thinking0things/duckbert/cad/out_none_v1.1/Microduck_SG90_headless_v1_1.FCStd

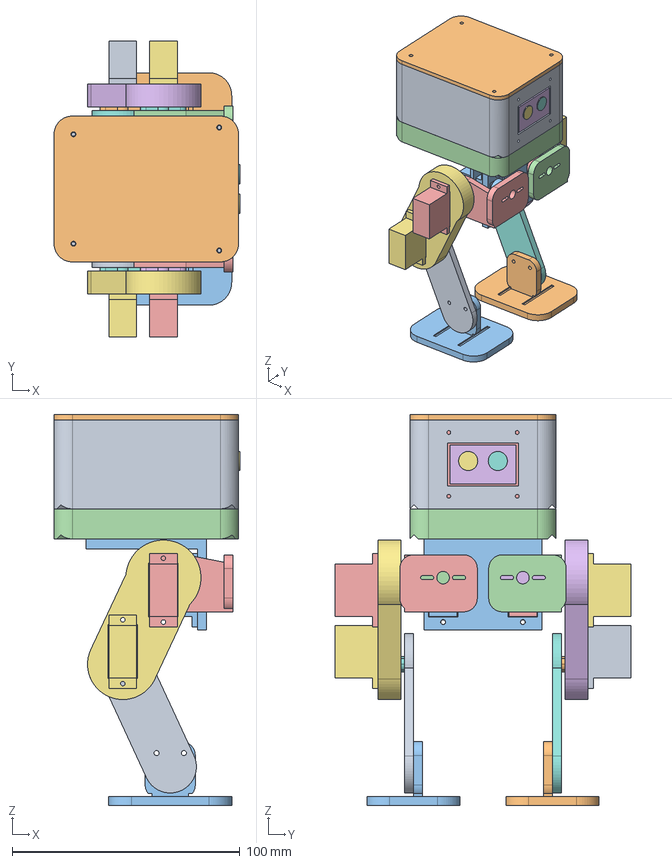
[picture p3: CAD file, 2026-09-23]
cad/out_none_v1.1/Microduck_SG90_headless_v1_1.FCStd
81.6 x 130.0 x 171.6 mm
01 trunk tub
02 trunk lid
03 hip block
04 hip bracket L
04 hip bracket R
05 thigh L
05 thigh R
06 shin L
06 shin R
07 foot L
07 foot R
15 lipo cassette
L_hip_roll
L_hip_roll_stock_horn
L_hip_pitch
L_hip_pitch_stock_horn
L_knee
L_knee_stock_horn
R_hip_roll
R_hip_roll_stock_horn
R_hip_pitch
R_hip_pitch_stock_horn
R_knee
R_knee_stock_horn
ESP32_C3_shield_envelope
regulator_5V_envelope
IMU_GY521_envelope
battery_lipo_envelope
OLED_1in3_envelope
OLED_screen
OLED_eye_R
OLED_eye_L
