thinking0things/duckbert/cad/out_none_v1.1/plates/plate_all_parts.stl

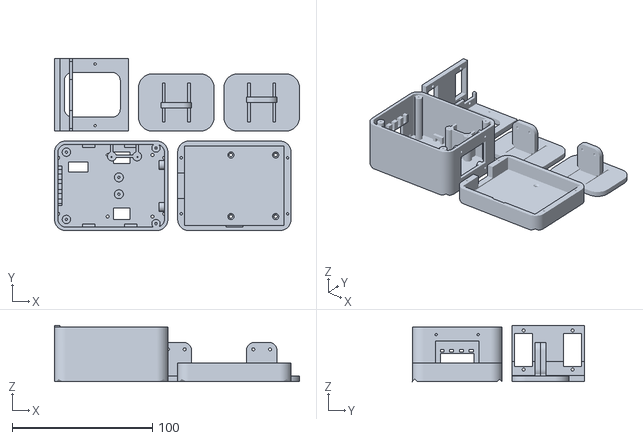
[picture p4: CAD file, 2026-09-23]
cad/out_none_v1.1/plates/plate_all_parts.stl
175.0 x 123.0 x 40.0
