thinking0things/duckbert/cad/out_none_v1.1/stl/07_foot_L.stl

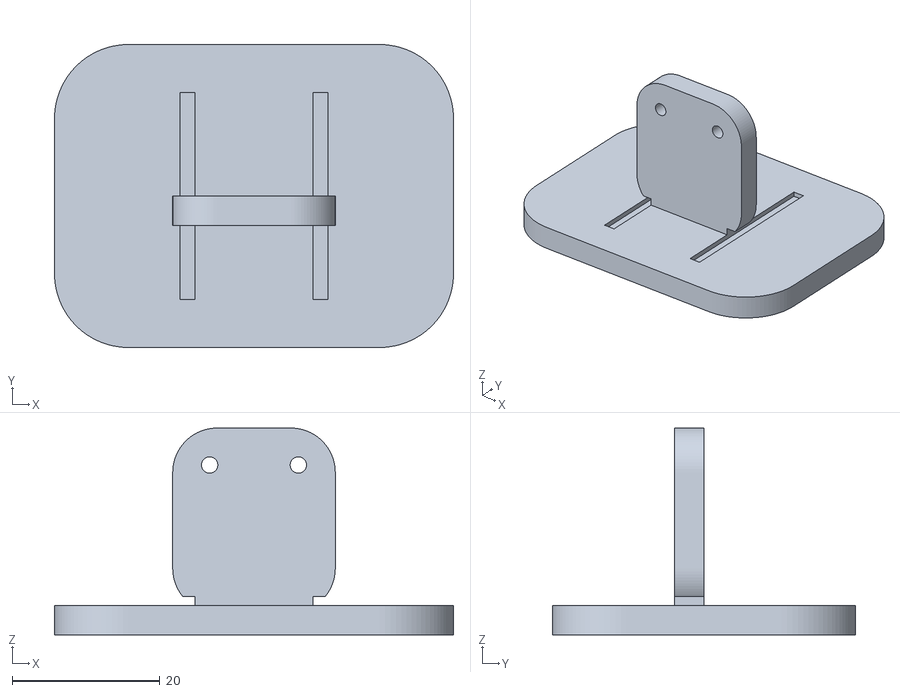
[picture p5: CAD file, 2026-09-23]
cad/out_none_v1.1/stl/07_foot_L.stl
54.0 x 41.0 x 28.0
