thinking0things/duckbert/cad/v1.3/Duckbert_v1_3.FCStd

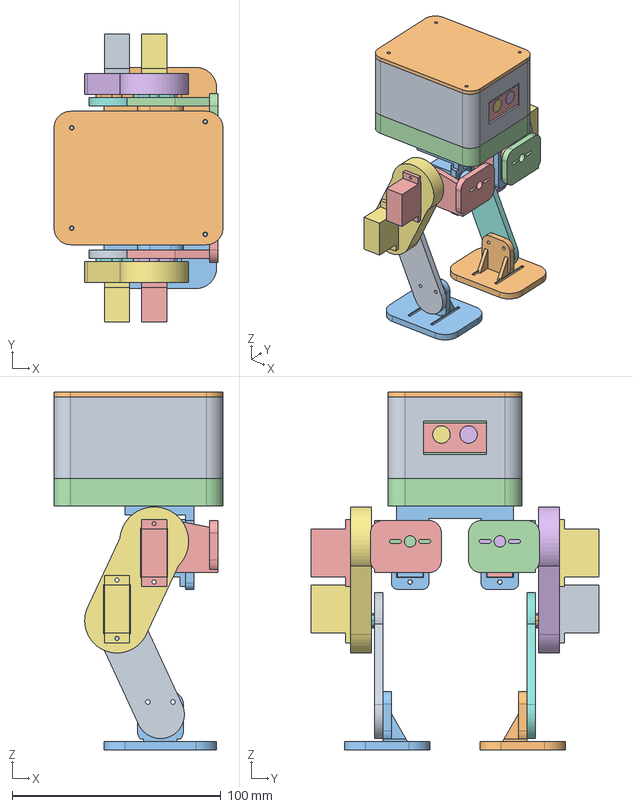
[picture p6: CAD file, 2026-10-14]
cad/v1.3/Duckbert_v1_3.FCStd
81.0 x 138.0 x 171.6 mm
01 trunk tub — r3 leads, USB, gyro 17, shield 10, OLED bosses
02 trunk lid
03 hip block — hip22 r2 supported front bridge
04 hip bracket L
04 hip bracket R
05 thigh L
05 thigh R
06 shin L
06 shin R
07 foot L
07 foot R
15 lipo cassette
L_hip_roll
L_hip_roll_stock_horn
L_hip_pitch
L_hip_pitch_stock_horn
L_knee
L_knee_stock_horn
R_hip_roll
R_hip_roll_stock_horn
R_hip_pitch
R_hip_pitch_stock_horn
R_knee
R_knee_stock_horn
regulator_5V_envelope
IMU_GY521_envelope
battery_lipo_65x55x10
OLED_1in3_envelope
OLED_screen
OLED_eye_L
OLED_eye_R
ESP32-C3 shield — existing 30 x 26 mm envelope
