thinking0things/duckbert/cad/v1.3/hip_block_r2/03_hip_block_hip22_r2.step

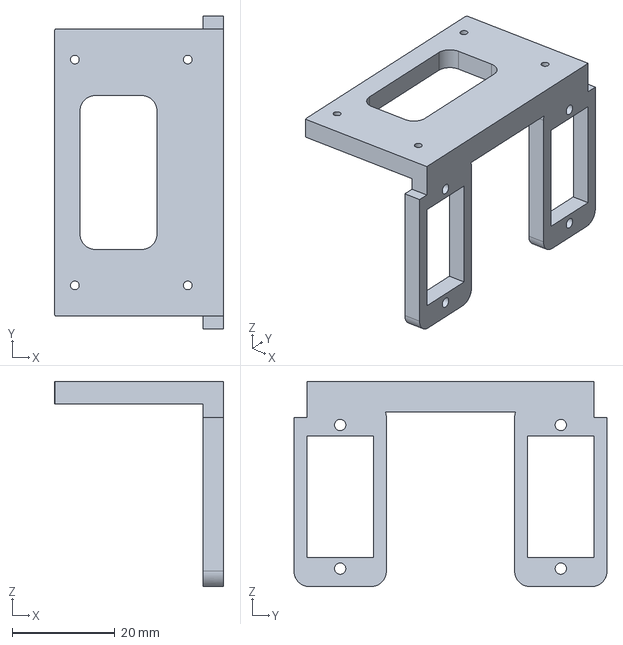
[picture p7: CAD file, 2026-10-14]
cad/v1.3/hip_block_r2/03_hip_block_hip22_r2.step
33.0 x 61.0 x 40.0 mm
