thinking0things/duckbert/cad/v1.3/step/05_thigh_L.step

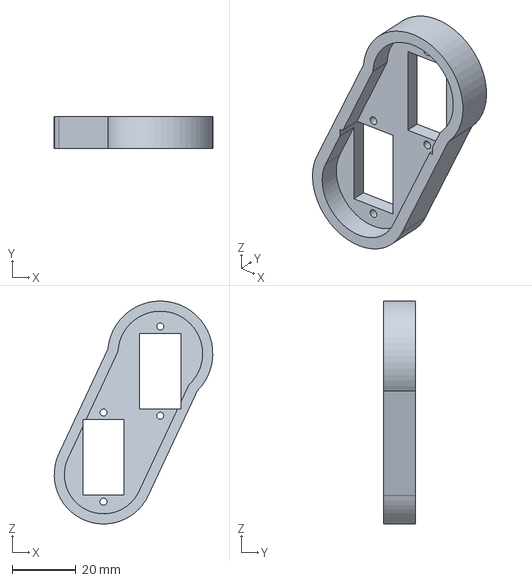
[picture p8: CAD file, 2026-10-14]
cad/v1.3/step/05_thigh_L.step
49.8 x 10.0 x 70.0 mm
