thinking0things/duckbert/cad/v1.3/step/shoes/01_rocker_shoe.step

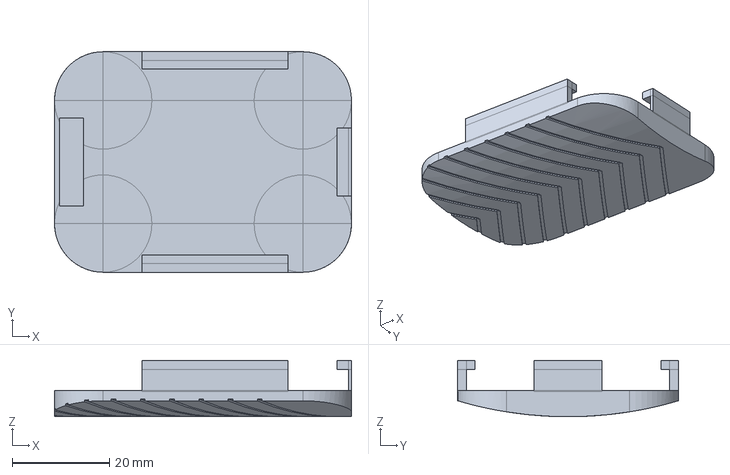
[picture p9: CAD file, 2026-10-14]
cad/v1.3/step/shoes/01_rocker_shoe.step
61.0 x 45.3 x 11.6 mm
