thinking0things/duckbert/dist/assets/meshes/R_hip_roll.stl

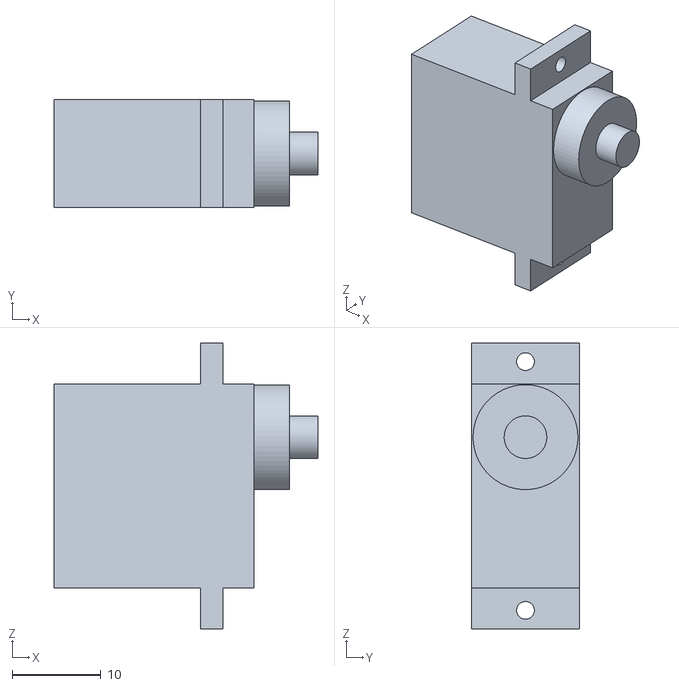
[picture p10: CAD file, 2026-09-24]
dist/assets/meshes/R_hip_roll.stl
29.7 x 12.2 x 32.2
