thinking0things/duckbert/print/00_servo_fit_coupon.stl

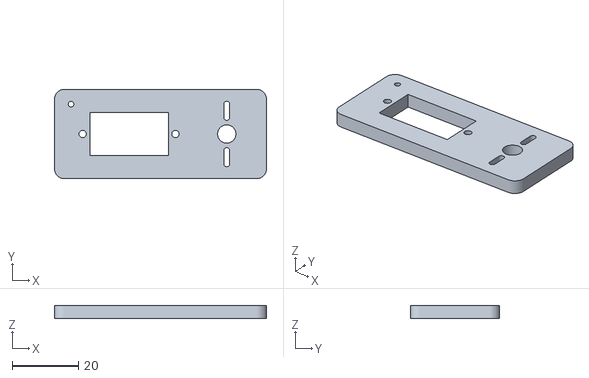
[picture p11: CAD file, 2026-09-23]
print/00_servo_fit_coupon.stl
64.0 x 27.0 x 4.00
