thinking0things/duckbert/print/body/01_trunk_tub.3mf

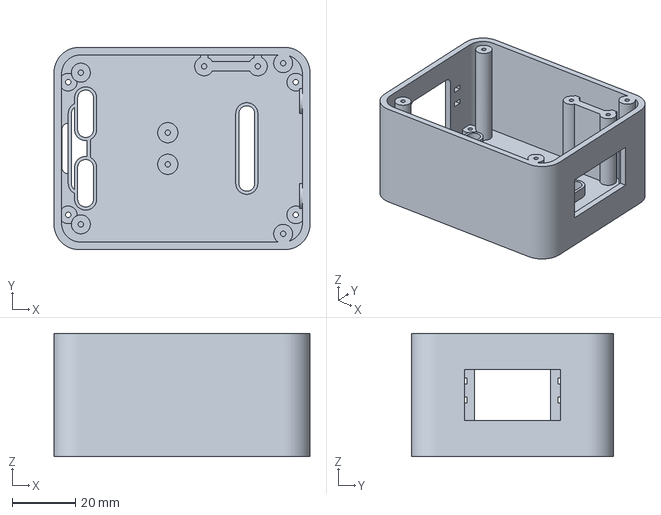
[picture p12: CAD file, 2026-10-14]
print/body/01_trunk_tub.3mf
81.0 x 64.0 x 39.0 mm
