thinking0things/duckbert/print/hips/04_hip_bracket_L.stl

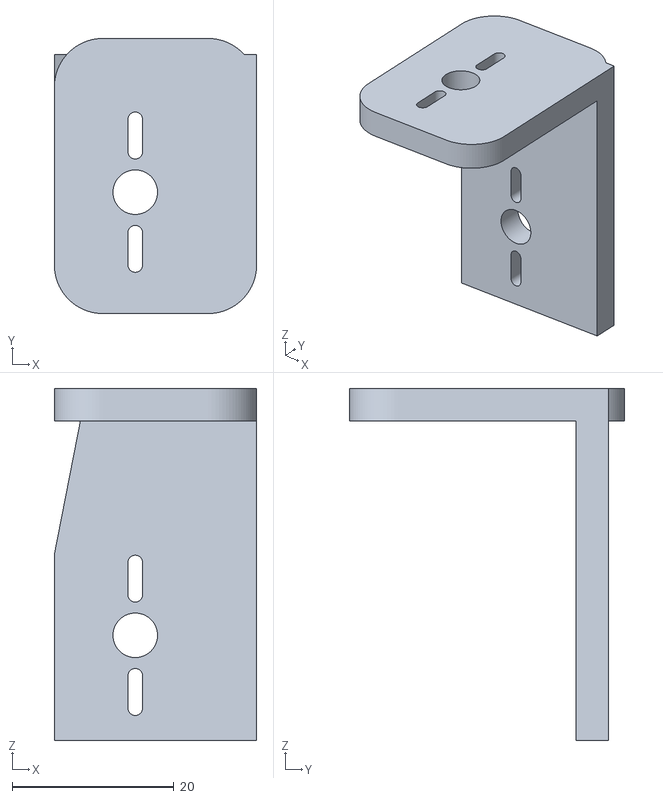
[picture p13: CAD file, 2026-10-14]
print/hips/04_hip_bracket_L.stl
25.0 x 34.0 x 43.5
