thinking0things/duckbert/print/shoes/shoes_plate_x2.3mf

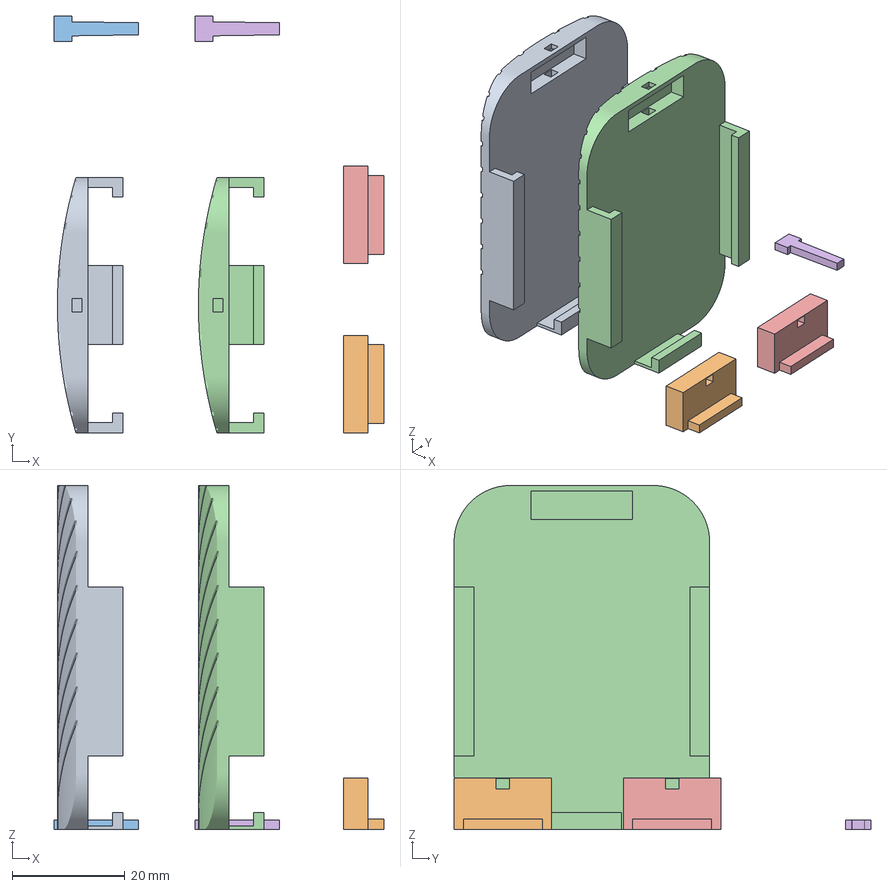
[picture p14: CAD file, 2026-10-14]
print/shoes/shoes_plate_x2.3mf
58.5 x 73.9 x 61.0 mm
01_rocker_shoe
02_rear_gate
03_taper_key
