thinking0things/duckbert/cad/out_none_v1.1/stl/01_trunk_tub.stl

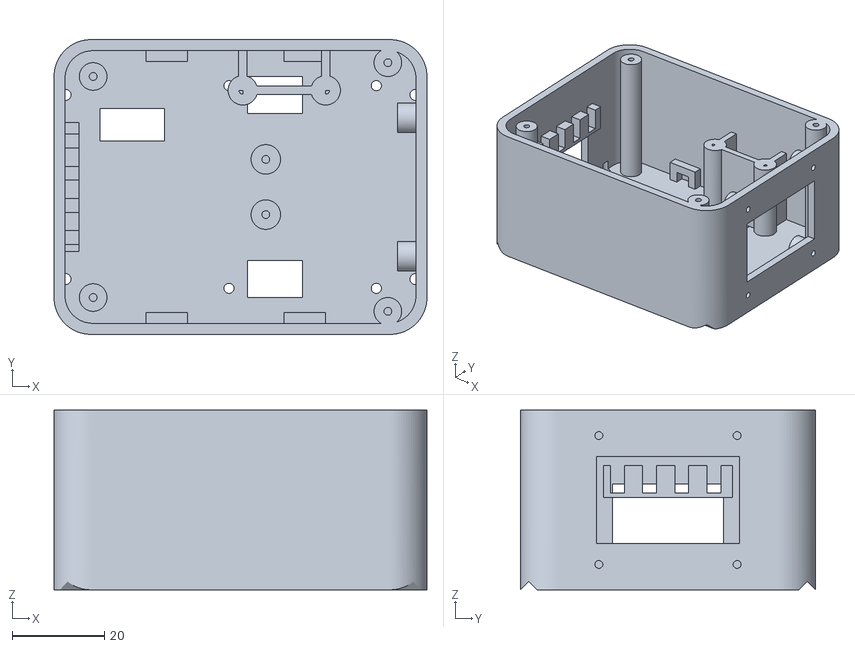
[picture p15: CAD file, 2026-09-23]
cad/out_none_v1.1/stl/01_trunk_tub.stl
81.0 x 64.0 x 39.0
