thinking0things/duckbert/cad/v1.3/step/07_foot_L.step

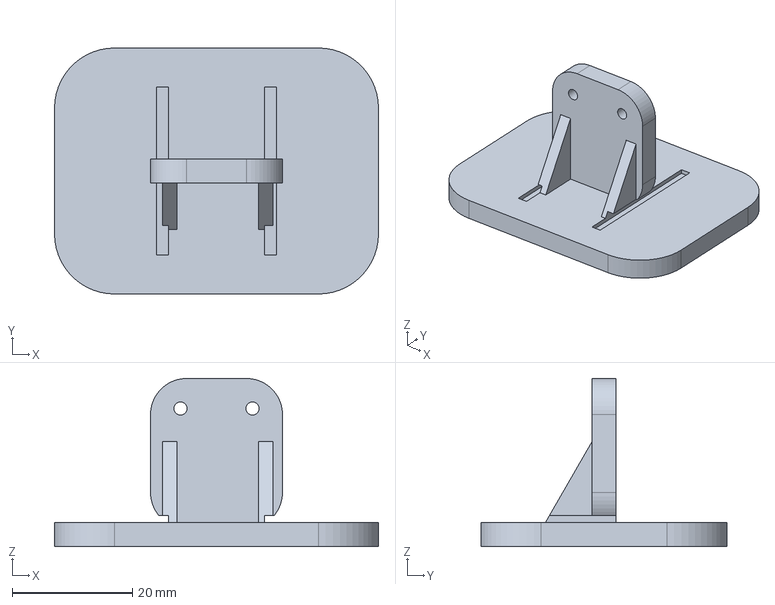
[picture p16: CAD file, 2026-10-14]
cad/v1.3/step/07_foot_L.step
54.0 x 41.0 x 28.0 mm
