thinking0things/duckbert/cad/v1.3/step/shoes/03_taper_key.step

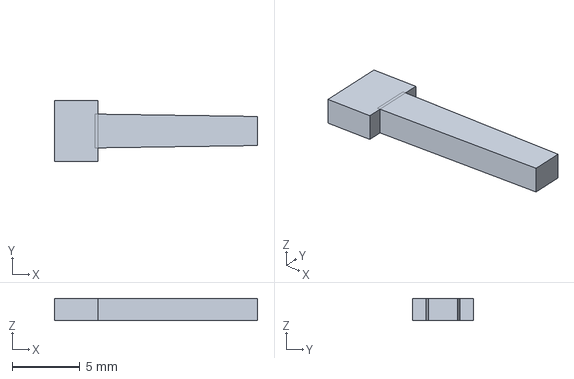
[picture p17: CAD file, 2026-10-14]
cad/v1.3/step/shoes/03_taper_key.step
15.0 x 4.50 x 1.65 mm
