thinking0things/duckbert/dist/assets/meshes/06_shin_L.stl

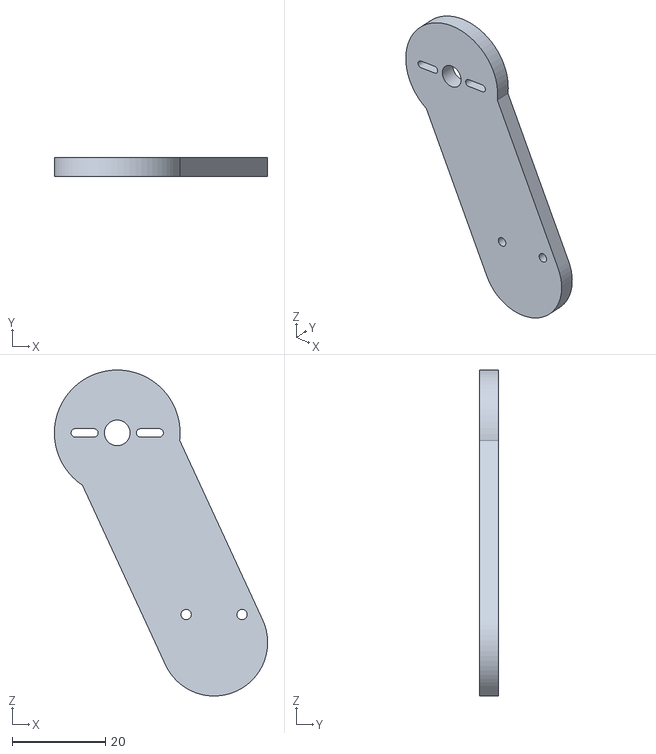
[picture p18: CAD file, 2026-09-24]
dist/assets/meshes/06_shin_L.stl
45.8 x 4.00 x 70.0
