thinking0things/duckbert/print/body/02_trunk_lid.stl

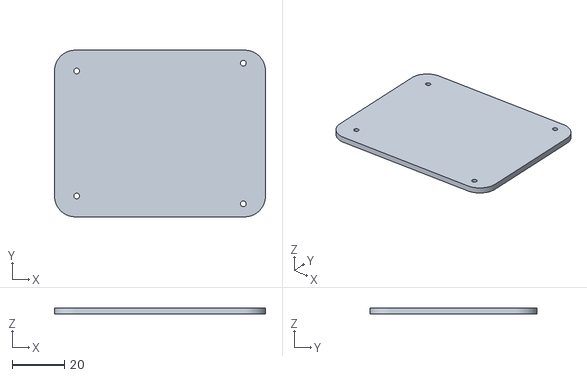
[picture p19: CAD file, 2026-09-23]
print/body/02_trunk_lid.stl
81.0 x 64.0 x 2.40
