thinking0things/duckbert/cad/out_none_v1.1/stl/15_lipo_cassette.stl

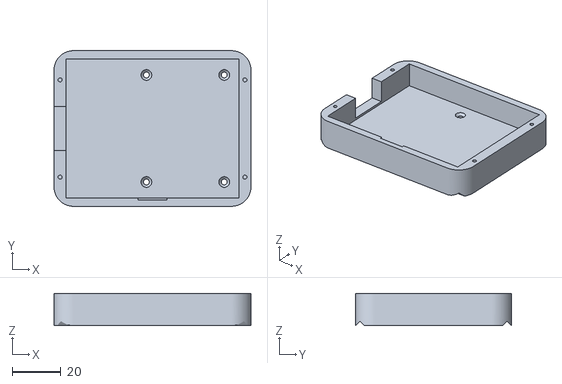
[picture p20: CAD file, 2026-09-23]
cad/out_none_v1.1/stl/15_lipo_cassette.stl
81.0 x 64.0 x 13.2
