thinking0things/duckbert/cad/v1.3/step/shoes/00_fit_coupon.step

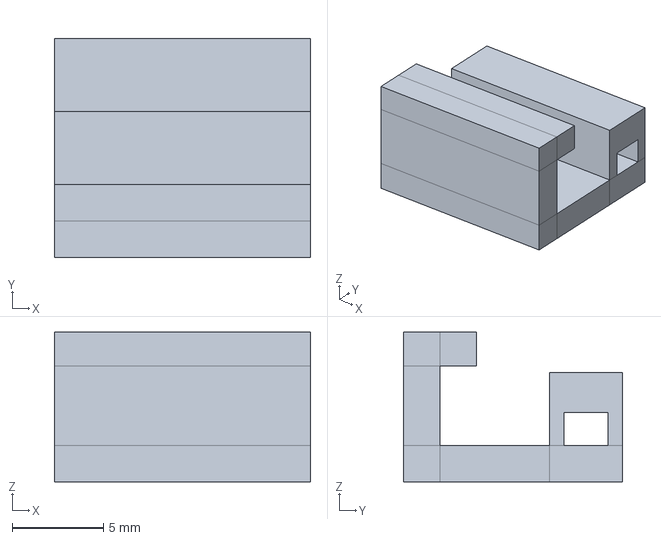
[picture p21: CAD file, 2026-10-14]
cad/v1.3/step/shoes/00_fit_coupon.step
14.0 x 12.0 x 8.20 mm
