thinking0things/duckbert/dist/assets/meshes/L_knee_stock_horn.stl

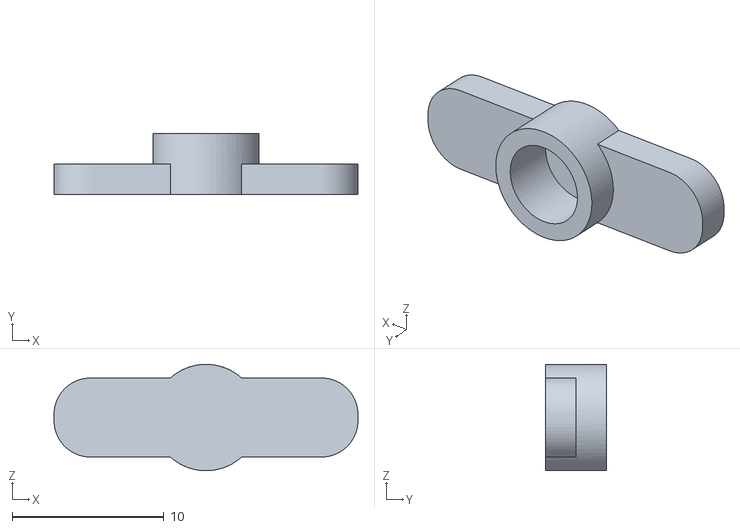
[picture p22: CAD file, 2026-09-24]
dist/assets/meshes/L_knee_stock_horn.stl
20.0 x 4.00 x 7.00
