thinking0things/duckbert/print/hips/03_hip_block.stl

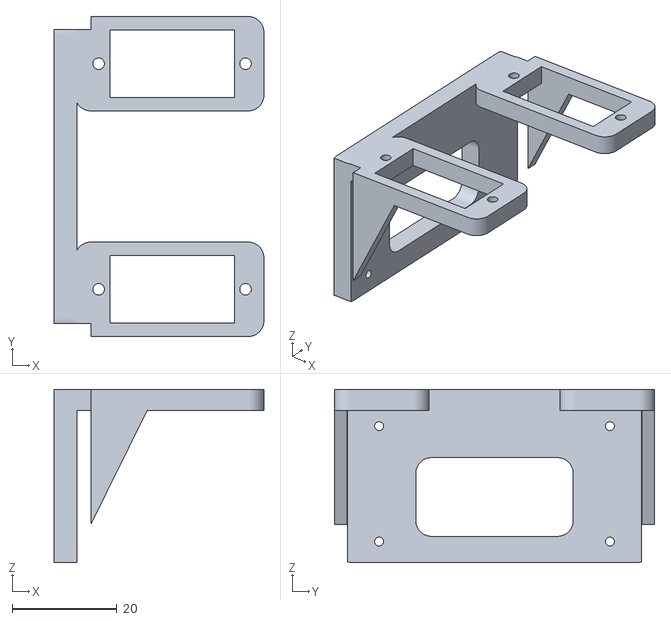
[picture p23: CAD file, 2026-10-14]
print/hips/03_hip_block.stl
40.0 x 61.0 x 33.0
