thinking0things/duckbert/print/shoes/shoe_fit_test.3mf

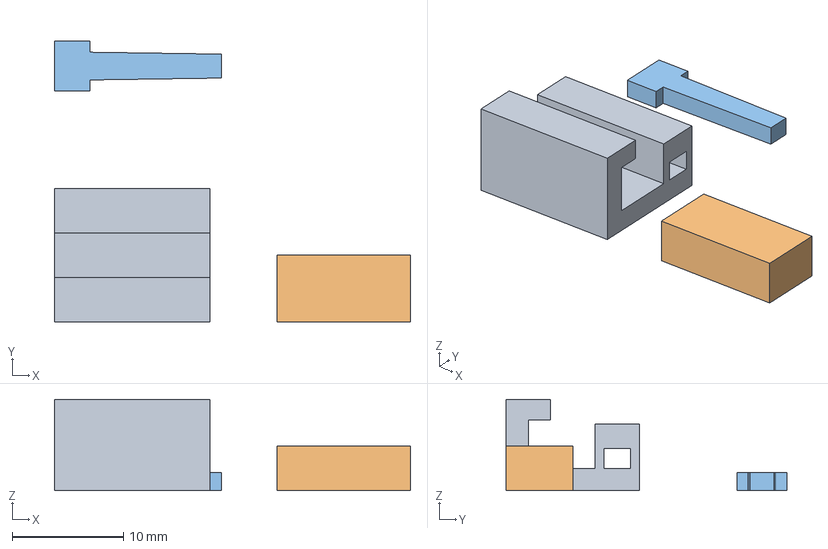
[picture p24: CAD file, 2026-10-14]
print/shoes/shoe_fit_test.3mf
32.0 x 25.2 x 8.20 mm
00_fit_coupon
00_fit_tab
03_taper_key
