thinking0things/duckbert/cad/out_none_v1.1/stl/03_hip_block.stl

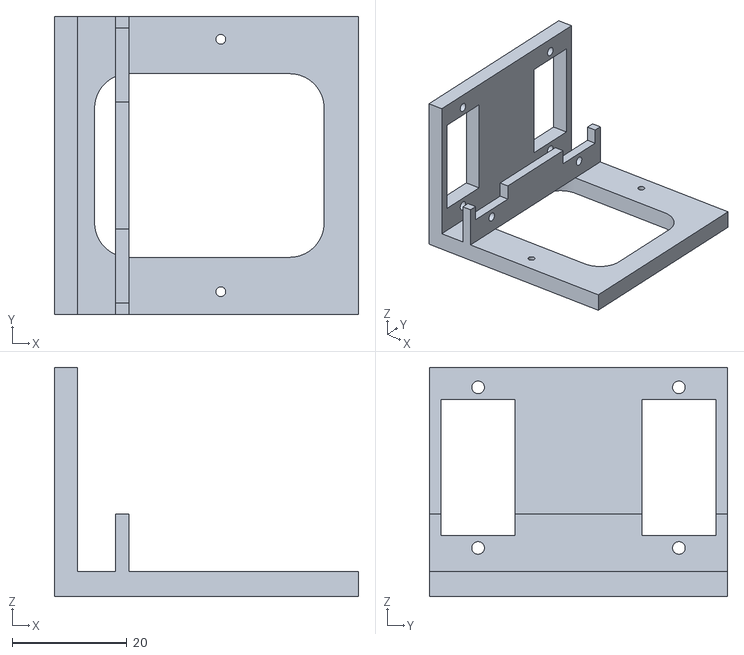
[picture p25: CAD file, 2026-09-23]
cad/out_none_v1.1/stl/03_hip_block.stl
53.0 x 52.0 x 40.0
