thinking0things/duckbert/cad/v1.3/step/shoes/00_fit_tab.step

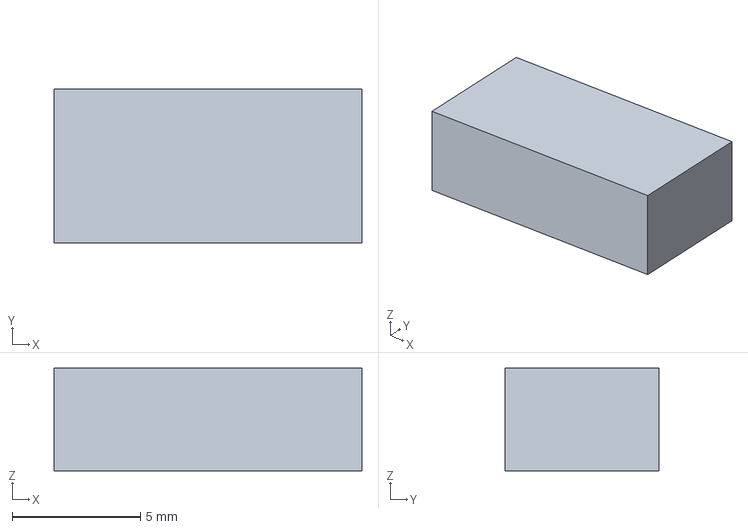
[picture p26: CAD file, 2026-10-14]
cad/v1.3/step/shoes/00_fit_tab.step
12.0 x 6.00 x 4.00 mm
