thinking0things/duckbert/dist/assets/meshes/OLED_1in3_envelope.stl

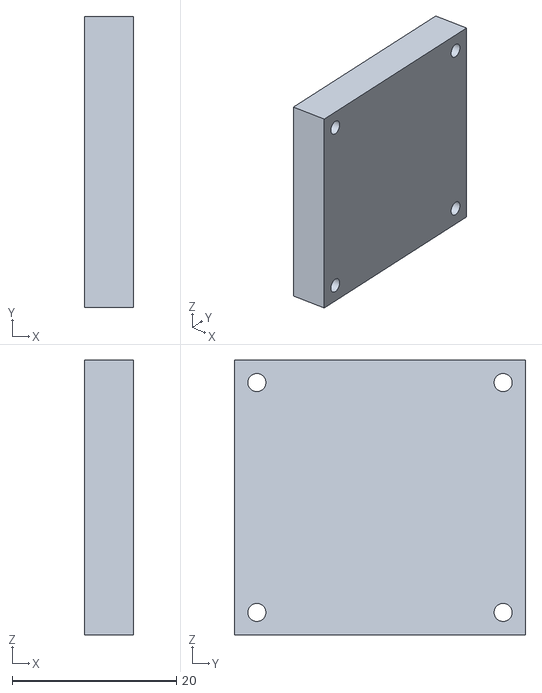
[picture p27: CAD file, 2026-09-24]
dist/assets/meshes/OLED_1in3_envelope.stl
6.00 x 35.5 x 33.5
