thinking0things/duckbert/print/shoes/02_rear_gate.stl

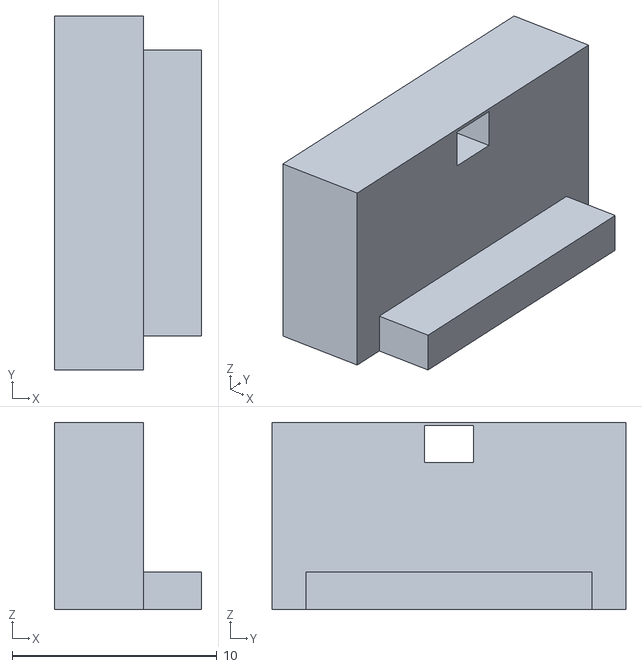
[picture p28: CAD file, 2026-10-14]
print/shoes/02_rear_gate.stl
7.20 x 17.3 x 9.15
