thinking0things/duckbert/cad/v1.3/step/shoes/02_rear_gate.step

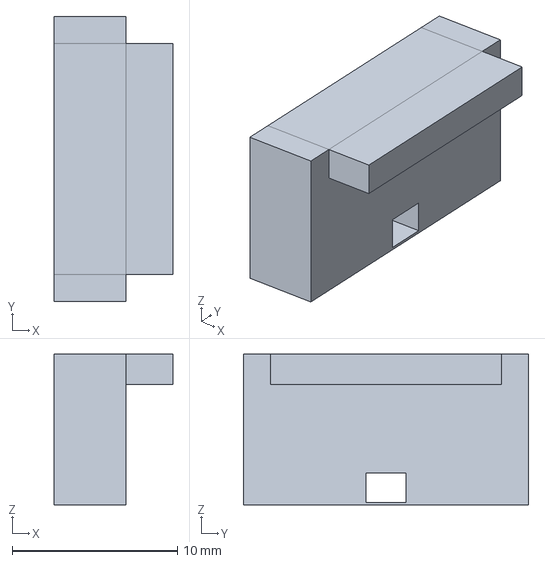
[picture p29: CAD file, 2026-10-14]
cad/v1.3/step/shoes/02_rear_gate.step
7.20 x 17.3 x 9.15 mm
