thinking0things/duckbert/dist/assets/meshes/PCA9685_driver_envelope.stl

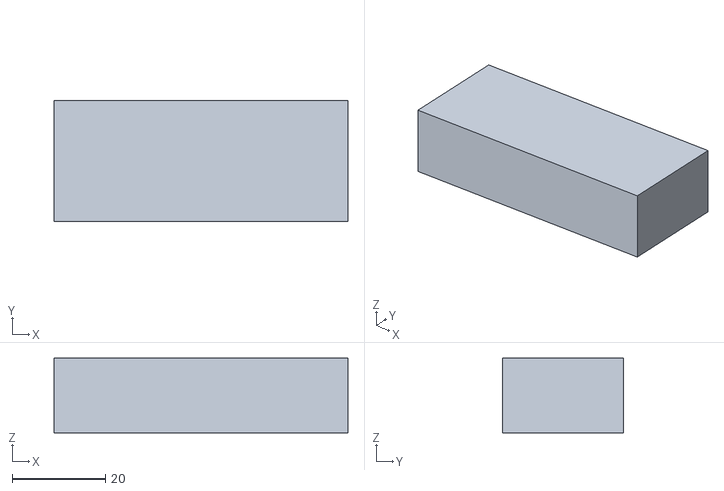
[picture p30: CAD file, 2026-09-24]
dist/assets/meshes/PCA9685_driver_envelope.stl
63.0 x 26.0 x 16.0
