thinking0things/duckbert/dist/assets/meshes/03_hip_block.stl

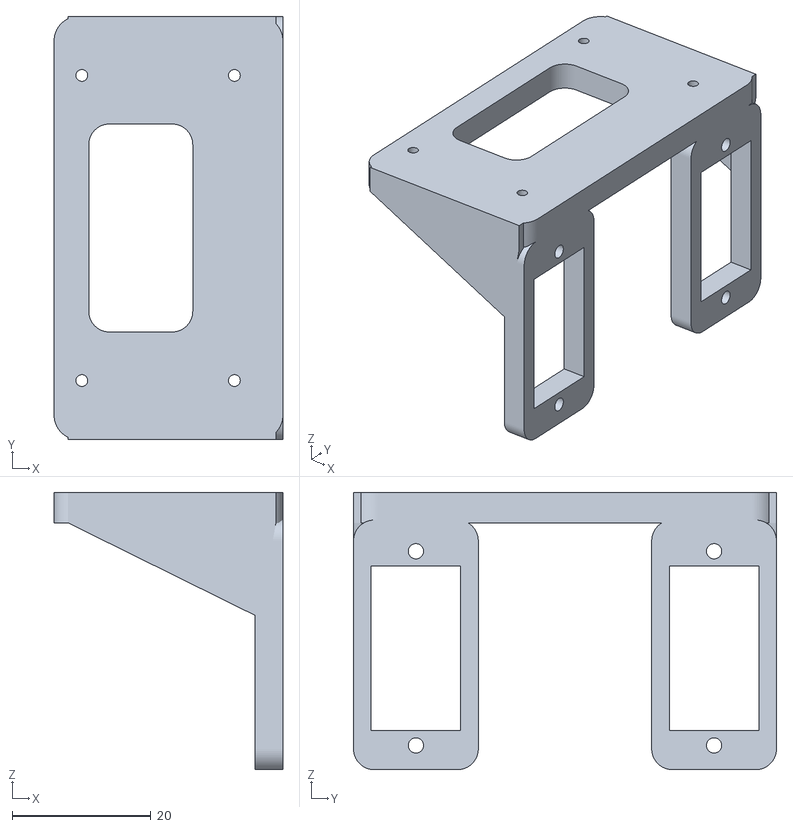
[picture p31: CAD file, 2026-09-24]
dist/assets/meshes/03_hip_block.stl
33.0 x 61.0 x 40.0
