thinking0things/duckbert/dist/assets/meshes/regulator_5V_envelope.stl

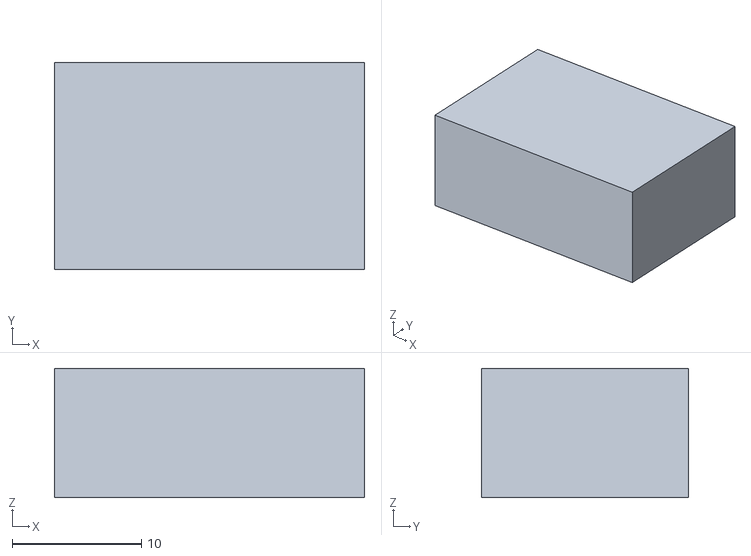
[picture p32: CAD file, 2026-09-24]
dist/assets/meshes/regulator_5V_envelope.stl
24.0 x 16.0 x 10.0
