thinking0things/duckbert/cad/v1.3/step/06_shin_L.step

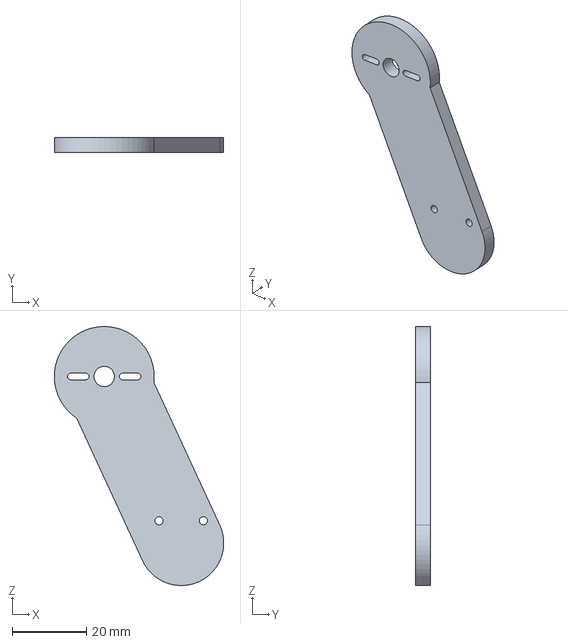
[picture p33: CAD file, 2026-10-14]
cad/v1.3/step/06_shin_L.step
45.8 x 4.00 x 70.0 mm
