thinking0things/duckbert/dist/assets/meshes/ESP32_C3_SuperMini_envelope.stl

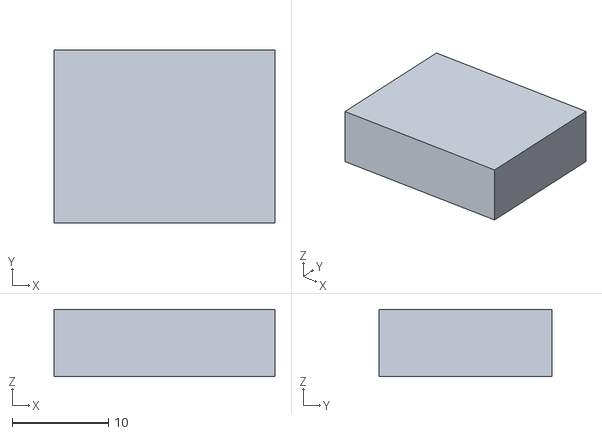
[picture p34: CAD file, 2026-09-24]
dist/assets/meshes/ESP32_C3_SuperMini_envelope.stl
23.0 x 18.0 x 7.00
