thinking0things/duckbert/dist/assets/meshes/OLED_screen.stl

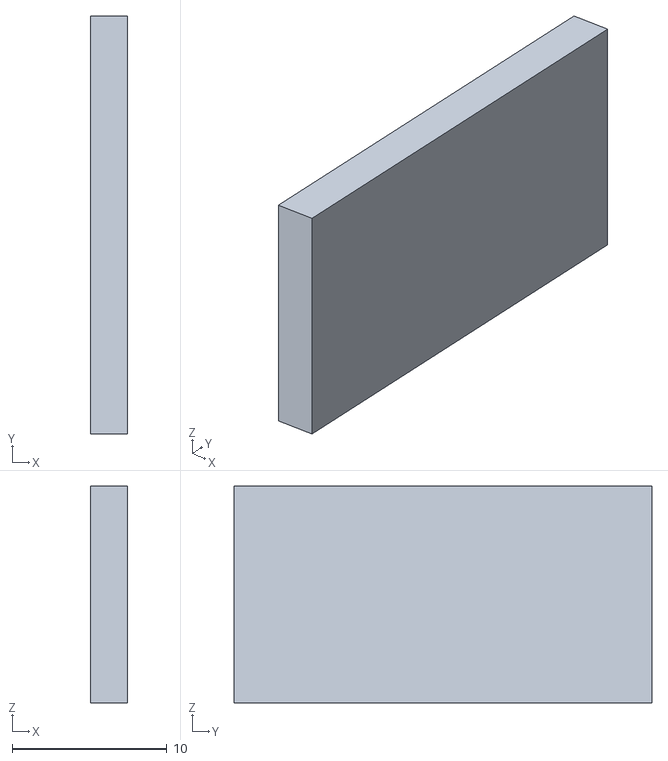
[picture p35: CAD file, 2026-09-24]
dist/assets/meshes/OLED_screen.stl
2.40 x 27.0 x 14.0
