thinking0things/duckbert/dist/assets/meshes/IMU_GY521_envelope.stl

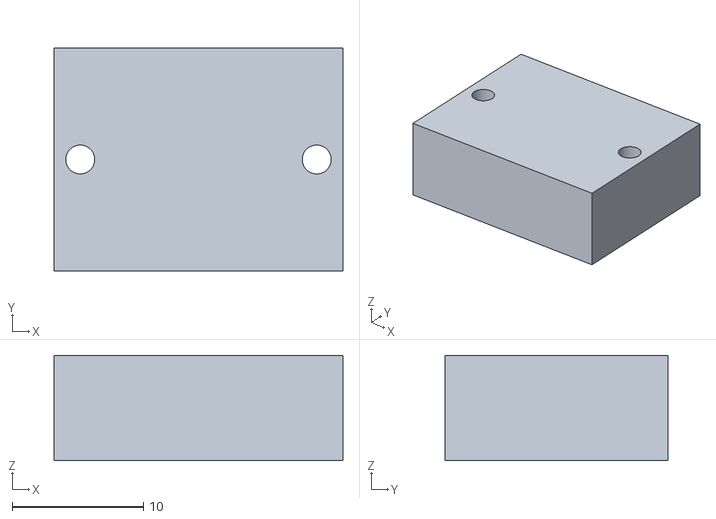
[picture p36: CAD file, 2026-09-24]
dist/assets/meshes/IMU_GY521_envelope.stl
22.0 x 17.0 x 8.00
