thinking0things/duckbert/dist/assets/meshes/OLED_eye_R.stl

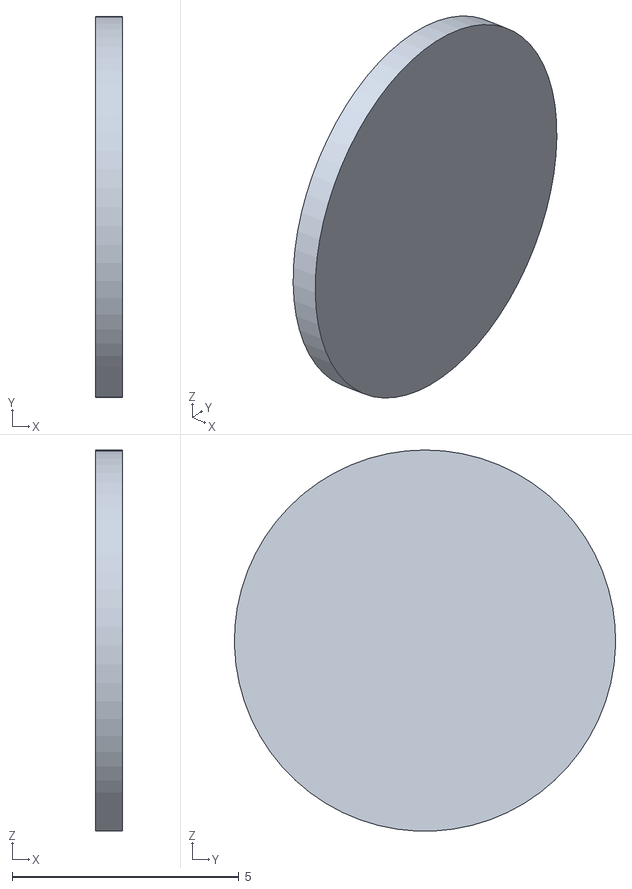
[picture p37: CAD file, 2026-09-20]
dist/assets/meshes/OLED_eye_R.stl
0.6 x 8.40 x 8.39
