thinking0things/duckbert/dist/assets/meshes/battery_lipo_65x55x10.stl

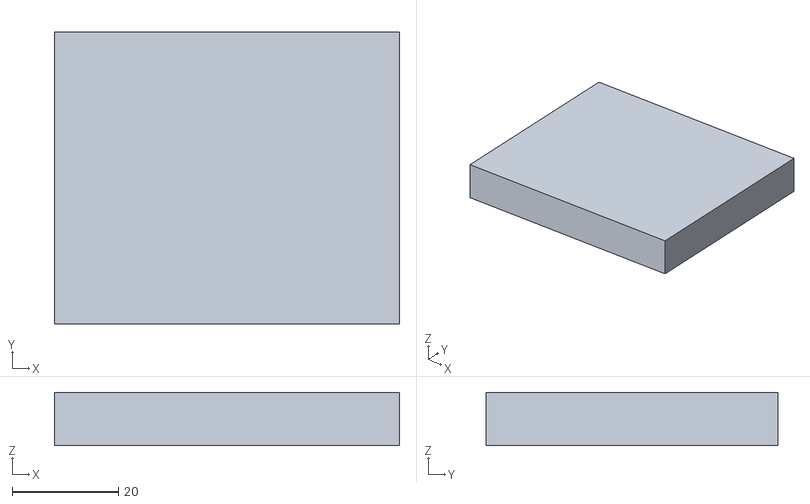
[picture p38: CAD file, 2026-09-20]
dist/assets/meshes/battery_lipo_65x55x10.stl
65.0 x 55.0 x 10.00
