thinking0things/duckbert/(list of files, cad)

Other CAD files:
print/legs/05_thigh_R.stl
print/hips/04_hip_bracket_R.stl
print/legs/05_thigh_L.stl
print/shoes/01_rocker_shoe.stl
cad/v1.3/step/04_hip_bracket_R.step
print/legs/06_shin_L.stl
cad/v1.3/step/04_hip_bracket_L.step
print/legs/06_shin_R.stl
cad/out_none_v1.1/stl/07_foot_R.stl
cad/v1.3/step/03_hip_block.step
print/legs/07_foot_R.stl
print/shoes/03_taper_key.stl
cad/out_none_v1.1/stl/06_shin_L.stl
cad/v1.3/step/15_battery_cassette.step
print/legs/07_foot_L.stl
cad/out_none_v1.1/stl/05_thigh_R.stl
cad/v1.3/step/02_trunk_lid.step
dist/assets/meshes/L_hip_pitch.stl
cad/out_none_v1.1/stl/05_thigh_L.stl
cad/v1.3/step/07_foot_R.step
dist/assets/meshes/01_trunk_tub.stl
cad/out_none_v1.1/stl/06_shin_R.stl
cad/v1.3/step/06_shin_R.step
cad/out_none_v1.1/stl/04_hip_bracket_R.stl
cad/v1.3/step/01_trunk_tub.step
dist/assets/meshes/R_hip_roll_stock_horn.stl
cad/out_none_v1.1/stl/04_hip_bracket_L.stl
cad/v1.3/step/00_servo_fit_coupon.step
dist/assets/meshes/L_knee.stl
cad/v1.3/step/05_thigh_R.step
dist/assets/meshes/L_hip_roll.stl
dist/assets/meshes/L_hip_pitch_stock_horn.stl
dist/assets/meshes/04_hip_bracket_R.stl
dist/assets/meshes/R_knee_stock_horn.stl
dist/assets/meshes/R_hip_pitch.stl
dist/assets/meshes/L_hip_roll_stock_horn.stl
dist/assets/meshes/05_thigh_R.stl
dist/assets/meshes/04_hip_bracket_L.stl
dist/assets/meshes/05_thigh_L.stl
dist/assets/meshes/06_shin_R.stl
dist/assets/meshes/07_foot_L.stl
dist/assets/meshes/R_hip_pitch_stock_horn.stl
dist/assets/meshes/R_knee.stl
dist/assets/meshes/15_lipo_cassette.stl
dist/assets/meshes/07_foot_R.stl
dist/assets/meshes/02_trunk_lid.stl
dist/assets/meshes/OLED_eye_L.stl
cad/v1.3/hip_block_r2/03_hip_block_hip22_r2.stl
print/body/01_trunk_tub.stl
