thinking0things/duckbert/docs/wiring.png

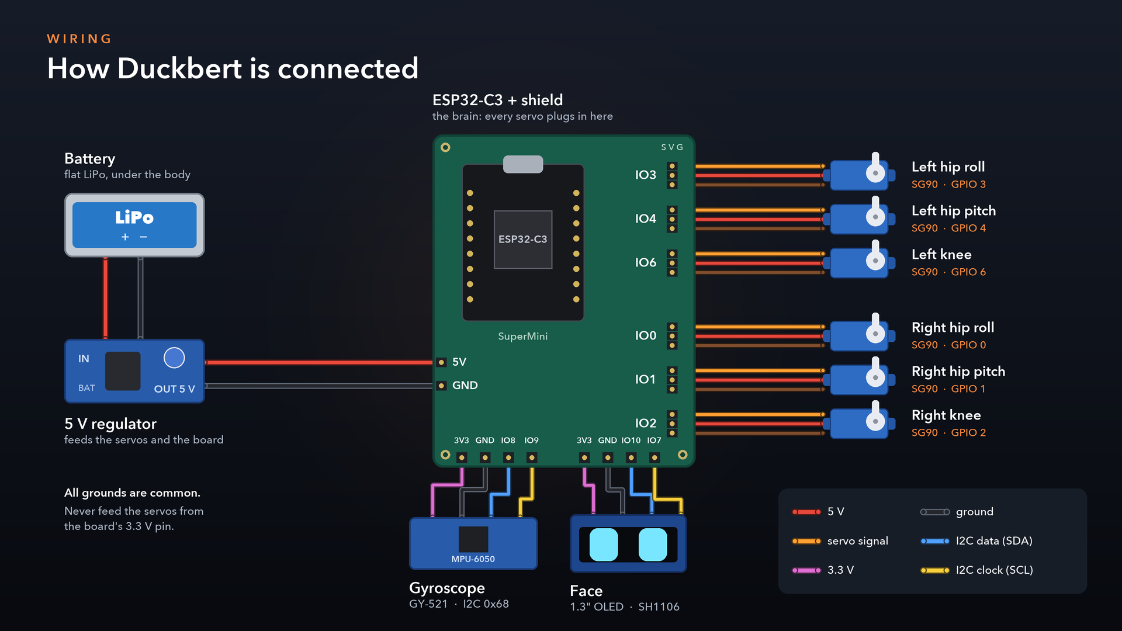
docs/wiring.png
