thinking0things/duckbert/print/shoes/preview.png

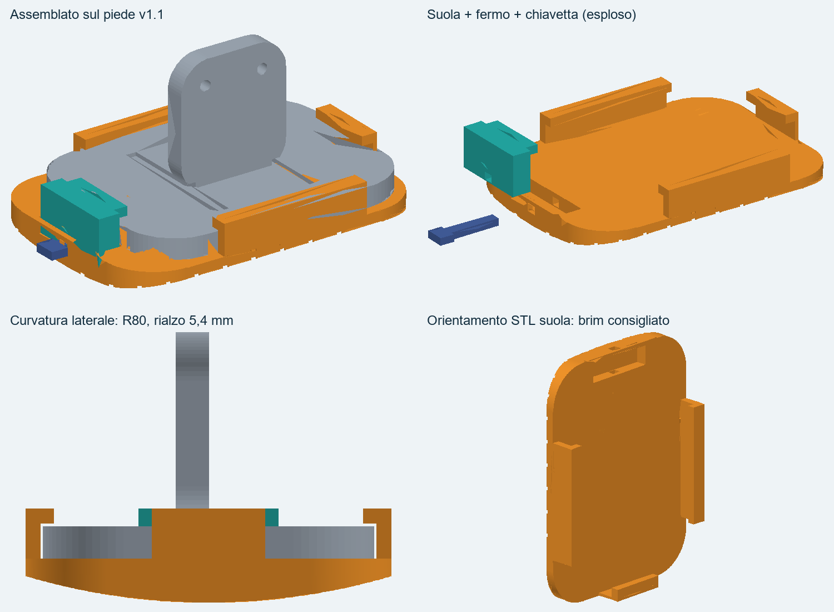
print/shoes/preview.png
