thinking0things/duckbert/print/shoes/print-orientation.png

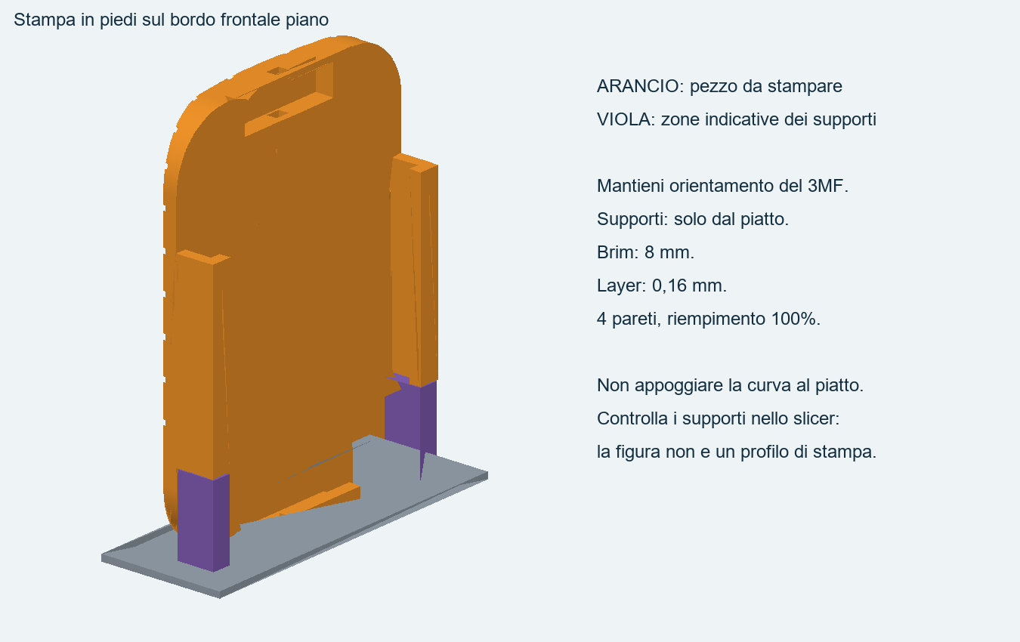
print/shoes/print-orientation.png
