thinking0things/duckbert/(commit log)

2026-09-19 Add headless walking simulation with directional controls
    [01_trunk_tub.stl, 02_trunk_lid.stl, 03_hip_block.stl, 04_hip_bracket_L.stl, 04_hip_bracket_R.stl, 05_thigh_L.stl, 05_thigh_R.stl, 06_shin_L.stl]
2026-09-20 Use v1.1 Claude CAD model in Bordeaux red with validated walking gait
    [01_trunk_tub.stl, 02_trunk_lid.stl, 03_hip_block.stl, 07_foot_L.stl, 07_foot_R.stl, 15_lipo_cassette.stl, ESP32_C3_SuperMini_envelope.stl, ESP32_C3_shield_envelope.stl]
2026-09-20 Add robot colour toggle, blue servos, OLED eyes and white ground grid
2026-09-21 Remove Claude from model names and docs
    The model is "Duckbert v1.1", the gait id is v11_walk and the CAD revision
    label is out_none_v1.1. robot.xml changed only in its model name, so its
    recorded sha256 in provenance.json is updated; npm test passes with the same
    simulation results as before.
2026-09-23 Add printable CAD and STL for v1.1
    The FreeCAD source, per-part STL and pre-arranged print plates for the
    same v1.1 body the simulation already imports. Not the final revision:
    the README in this folder lists the three known issues (lid fit, battery
    bay layout, assembly needing glue) that the next revision fixes.
    [00_fit_coupon.stl, 01_trunk_tub.stl, 02_trunk_lid.stl, 03_hip_block.stl, 04_hip_bracket_L.stl, 04_hip_bracket_R.stl, 05_thigh_L.stl, 05_thigh_R.stl]
2026-09-23 Fix cad/out_none_v1.1 to match the published simulation meshes
    The previous commit copied the wrong local CAD folder: the FreeCAD file,
    five STL parts (trunk tub, hip block, both feet, LiPo cassette) and the
    print plate now match dist/assets/provenance.json's mesh_sha256 exactly
    (32/32), so this is what the live simulation actually walks.
    [01_trunk_tub.stl, 03_hip_block.stl, 07_foot_L.stl, 07_foot_R.stl, 15_lipo_cassette.stl, Microduck_SG90_headless_v1_1.FCStd, charcoal.stl, cream.stl]
2026-09-23 Document the flat-sole, no-ankle walking limit
    New docs/walking-limits.md, linked from the README: the measured
    geometry limit (99 mm CoM height, 41 mm sole, 11deg of hip roll worth
    2.7 mm of CoM shift), what crouching buys (83 mm CoM at 40deg, +9%
    fall time, bench results for the two crouched gaits), and the two
    unbuilt candidates with the most headroom - cradle soles and ankle
    servos. Ported from the private fitting notes, not from the search
    loop itself.
2026-09-24 Import v1.2 CAD model with centered shoes
    [01_trunk_tub.stl, 03_hip_block.stl, 04_hip_bracket_L.stl, 04_hip_bracket_R.stl, 05_thigh_L.stl, 05_thigh_R.stl, 06_shin_L.stl, 06_shin_R.stl]
2026-10-14 Release the robot as built: print files, wiring, firmware and browser control
    - print/: every part of the walking robot in print orientation (v1.3 r3 body,
    Hip22 hip block, v1.3 legs, R80 rocker shoes), with quantities and settings
    - cad/v1.3/: STEP for every part, the FreeCAD assembly, and the stiffer r2 hip block
    - docs/wiring.png: the wiring diagram; docs/calibration.md: calibration step by step
    - firmware/duckbert_walk: the ESP32-C3 sketch (rock-and-step walk), with flashing notes
    - control/: the bridge and the two browser pages, guided calibration and drive
    - README: build guide on top, the simulation below
2026-10-21 Update firmware and the browser control to the best walk so far
    - firmware: the 20 Oct walk (timed foot lift, soft pump, 7 s settle), the
    video moves (push-ups, dance, lean, bow; show_moves.h) and a Wi-Fi scan
    - control/drive.html: simplified, all English; the best settings built in,
    hold an arrow to walk, plus the four moves
    - control/calibrate.html: the current guided calibration
    - control/wifi_join.py: join a network over USB, password never on disk
    - docs: the wiring diagram is removed (the pin list stays in the READMEs)
